ericdwatson/stm32-debug-board/hardware/manufacture/V1.0/assembly/stm32_debug_board_V1.0_JLCPCB_BOM.csv

Comment | Designator | Footprint | LCSC Part #
100nF | C1,C2,C3,C4,C5,C6,C7,C8,C9,C10,C11,C20,C21,C23,C25,C26,C29 | C_0805_2012Metric | C49678
30pF | C15,C16 | C_0603_1608Metric | C1658
2.2uF | C17,C18 | C_0805_2012Metric | C377773
4.7uF | C19 | C_0805_2012Metric | C1779
1uF | C22,C24 | C_0805_2012Metric | C28323
22uF | C27 | C_0805_2012Metric | C45783
22uF | C28 | CP_EIA-3528-21_Kemet-B | C7198
LED 0805 | D1,D2,D3 | LED_0805_2012Metric | C2296
500mA | F1 | Fuse_1206_3216Metric | C2984676
TYPE-C-31-M-12 | J1 | USB_C_Receptacle_HRO_TYPE-C-31-M-12 | C165948
FTSH-107-01-L-DV-K-A | J3 | SAMTEC_FTSH-107-01-L-DV-K-A | C5563894
100R | R1 | R_0805_2012Metric | C17408
1K | R2,R3,R4 | R_0805_2012Metric | C17513
10K | R5,R6,R7,R8 | R_0805_2012Metric | C17414
5.1K | R9,R10 | R_0805_2012Metric | C27834
Momentary switch | S1,S2 | SW_TS-1187A-B-A-B | C318884
STM32F446ZETx | U1 | LQFP-144_20x20mm_P0.5mm | C1337227
AMS1117-3.3 | U2 | SOT-223-3_TabPin2 | C6186
8 MHz | Y1 | Crystal_SMD_5032-2Pin_5.0x3.2mm | C115962
