ericdwatson/stm32-debug-board/hardware/docs/bom/stm32_debug_board.csv

Reference | Qty | Value | DNP | Exclude from BOM | Exclude from Board | Footprint | Datasheet | LCSC | MPN | Manufacturer | Farnell
C1,C2,C3,C4,C5,C6,C7,C8,C9,C10,C11,C20,C21,C23,C25,C26,C29 | 17 | 100nF |  |  |  | Capacitor_SMD:C_0805_2012Metric |  | C49678
C15,C16 | 2 | 30pF |  |  |  | Capacitor_SMD:C_0603_1608Metric |  | C1658 | 0603CG300J500NT | FH (Guangdong Fenghua Advanced Tech)
C17,C18 | 2 | 2.2uF |  |  |  | Capacitor_SMD:C_0805_2012Metric |  | C377773
C19 | 1 | 4.7uF |  |  |  | Capacitor_SMD:C_0805_2012Metric |  | C1779 | CL21A475KAQNNNE
C22,C24 | 2 | 1uF |  |  |  | Capacitor_SMD:C_0805_2012Metric |  | C28323
C27 | 1 | 22uF |  |  |  | Capacitor_SMD:C_0805_2012Metric |  | C45783 | CL21A226MAQNNNE
C28 | 1 | 22uF |  |  |  | Capacitor_Tantalum_SMD:CP_EIA-3528-21_Kemet-B |  | C7198 | TAJB226K010RNJ
D1 | 1 | PWR |  |  |  | LED_SMD:LED_0805_2012Metric |  | C2296 | KT-0805Y | Hubei KENTO Electronics
D2 | 1 | LED1 |  |  |  | LED_SMD:LED_0805_2012Metric |  | C2296 | KT-0805Y | Hubei KENTO Electronics
D3 | 1 | LED2 |  |  |  | LED_SMD:LED_0805_2012Metric |  | C2296 | KT-0805Y | Hubei KENTO Electronics
F1 | 1 | 500mA |  |  |  | Fuse:Fuse_1206_3216Metric |  | C2984676 | 500mA/24V | DOWO
J1 | 1 | TYPE-C-31-M-12 |  |  |  | Connector_USB:USB_C_Receptacle_HRO_TYPE-C-31-M-12 | https://www.usb.org/sites/default/files/documents/usb_type-c.zip | C165948 | TYPE-C-31-M-12 | Korean Hroparts Elec
J2 | 1 | Conn_02x10_Odd_Even |  |  |  | Connector_IDC:IDC-Header_2x10_P2.54mm_Vertical |  |  | TST-110-01-G-D | Samtec | 2667391
J3 | 1 | FTSH-107-01-L-DV-K-A |  |  |  | libraries:SAMTEC_FTSH-107-01-L-DV-K-A |  | C5563894 | FTSH-107-01-L-DV-K-A | Samtec
J4 | 1 | Conn_01x06 |  |  |  | Connector_PinHeader_2.54mm:PinHeader_1x06_P2.54mm_Vertical |  |  | TSW-106-07-G-S | Samtec | 2856716
J5 | 1 | Conn_01x02 |  |  |  | Connector_PinHeader_2.54mm:PinHeader_1x02_P2.54mm_Vertical |  |  |  | Samtec
R1 | 1 | 100R |  |  |  | Resistor_SMD:R_0805_2012Metric |  | C17408 | 0805W8F1000T5E | UNI-ROYAL
R2,R3,R4 | 3 | 1K |  |  |  | Resistor_SMD:R_0805_2012Metric |  | C17513 | 0805W8F1001T5E | UNI-ROYAL
R5,R6,R7,R8 | 4 | 10K |  |  |  | Resistor_SMD:R_0805_2012Metric |  | C17414 | 0805W8F1002T5E | UNI-ROYAL
R9,R10 | 2 | 5.1K |  |  |  | Resistor_SMD:R_0805_2012Metric |  | C27834 | 0805W8F5101T5E | UNI-ROYAL
S1 | 1 | User Button |  |  |  | libraries:SW_TS-1187A-B-A-B |  | C318884 | TS-1187A-B-A-B | XKB Industrial Precision
S2 | 1 | Reset Button |  |  |  | libraries:SW_TS-1187A-B-A-B |  | C318884 | TS-1187A-B-A-B | XKB Industrial Precision
U1 | 1 | STM32F446ZETx |  |  |  | Package_QFP:LQFP-144_20x20mm_P0.5mm | https://www.st.com/resource/en/datasheet/stm32f446ze.pdf | C1337227
U2 | 1 | AMS1117-3.3 |  |  |  | Package_TO_SOT_SMD:SOT-223-3_TabPin2 | http://www.advanced-monolithic.com/pdf/ds1117.pdf | C6186
Y1 | 1 | 8 MHz |  |  |  | Crystal:Crystal_SMD_5032-2Pin_5.0x3.2mm |  | C115962 | X50328MSB2GI | YXC
