ericdwatson/stm32-debug-board/hardware/docs/pdf/stm32_debug_board_v1_0.pdf

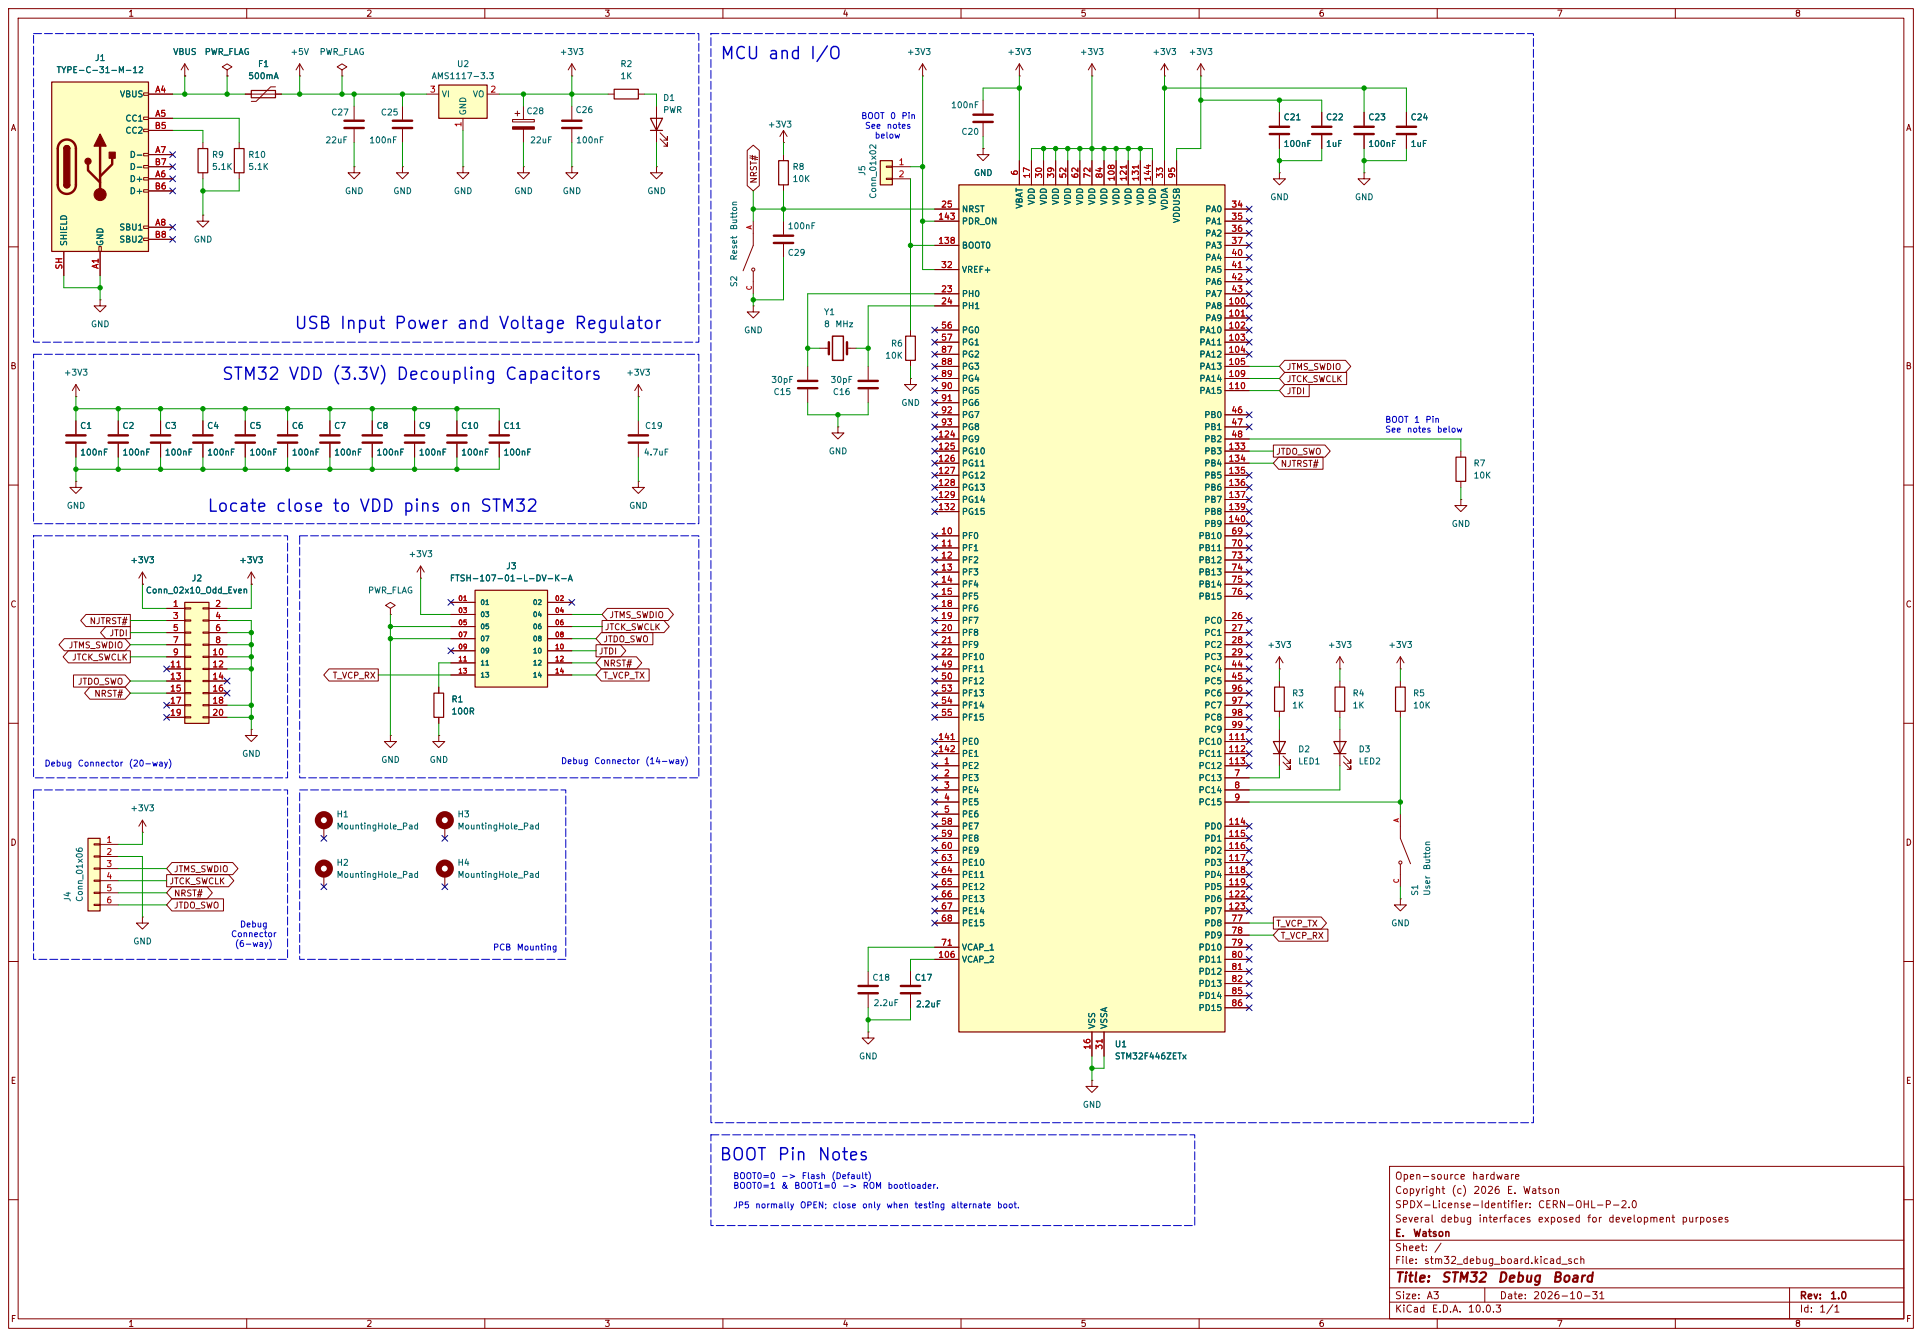
[picture p5: page 1]

BOOT 0 Pin See notes below

USB Input Power and Voltage Regulator

BOOT 1 Pin See notes below

Locate close to VDD pins on STM32

BOOT0=0 -> Flash (Default) BOOT0=1 & BOOT1=0 -> ROM bootloader. JP5 normally OPEN; close only when testing alternate boot. BOOT Pin Notes

Open-source hardware
Copyright (c) 2026 E. Watson
SPDX-License-Identifier: CERN-OHL-P-2.0
Several debug interfaces exposed for development purposes
E. Watson
Sheet: /
File: stm32_debug_board.kicad_sch
Title: STM32 Debug Board

Size: A3 | Rev: 1.0
KiCad E.D.A. 10.0.3 | Id: 1/1 | F Date: 2026-10-31
