ericdwatson/stm32-debug-board/hardware/stm32_debug_board.kicad_pcb

## KiCad design hardware/stm32_debug_board.kicad_pcb (2026-11-12)

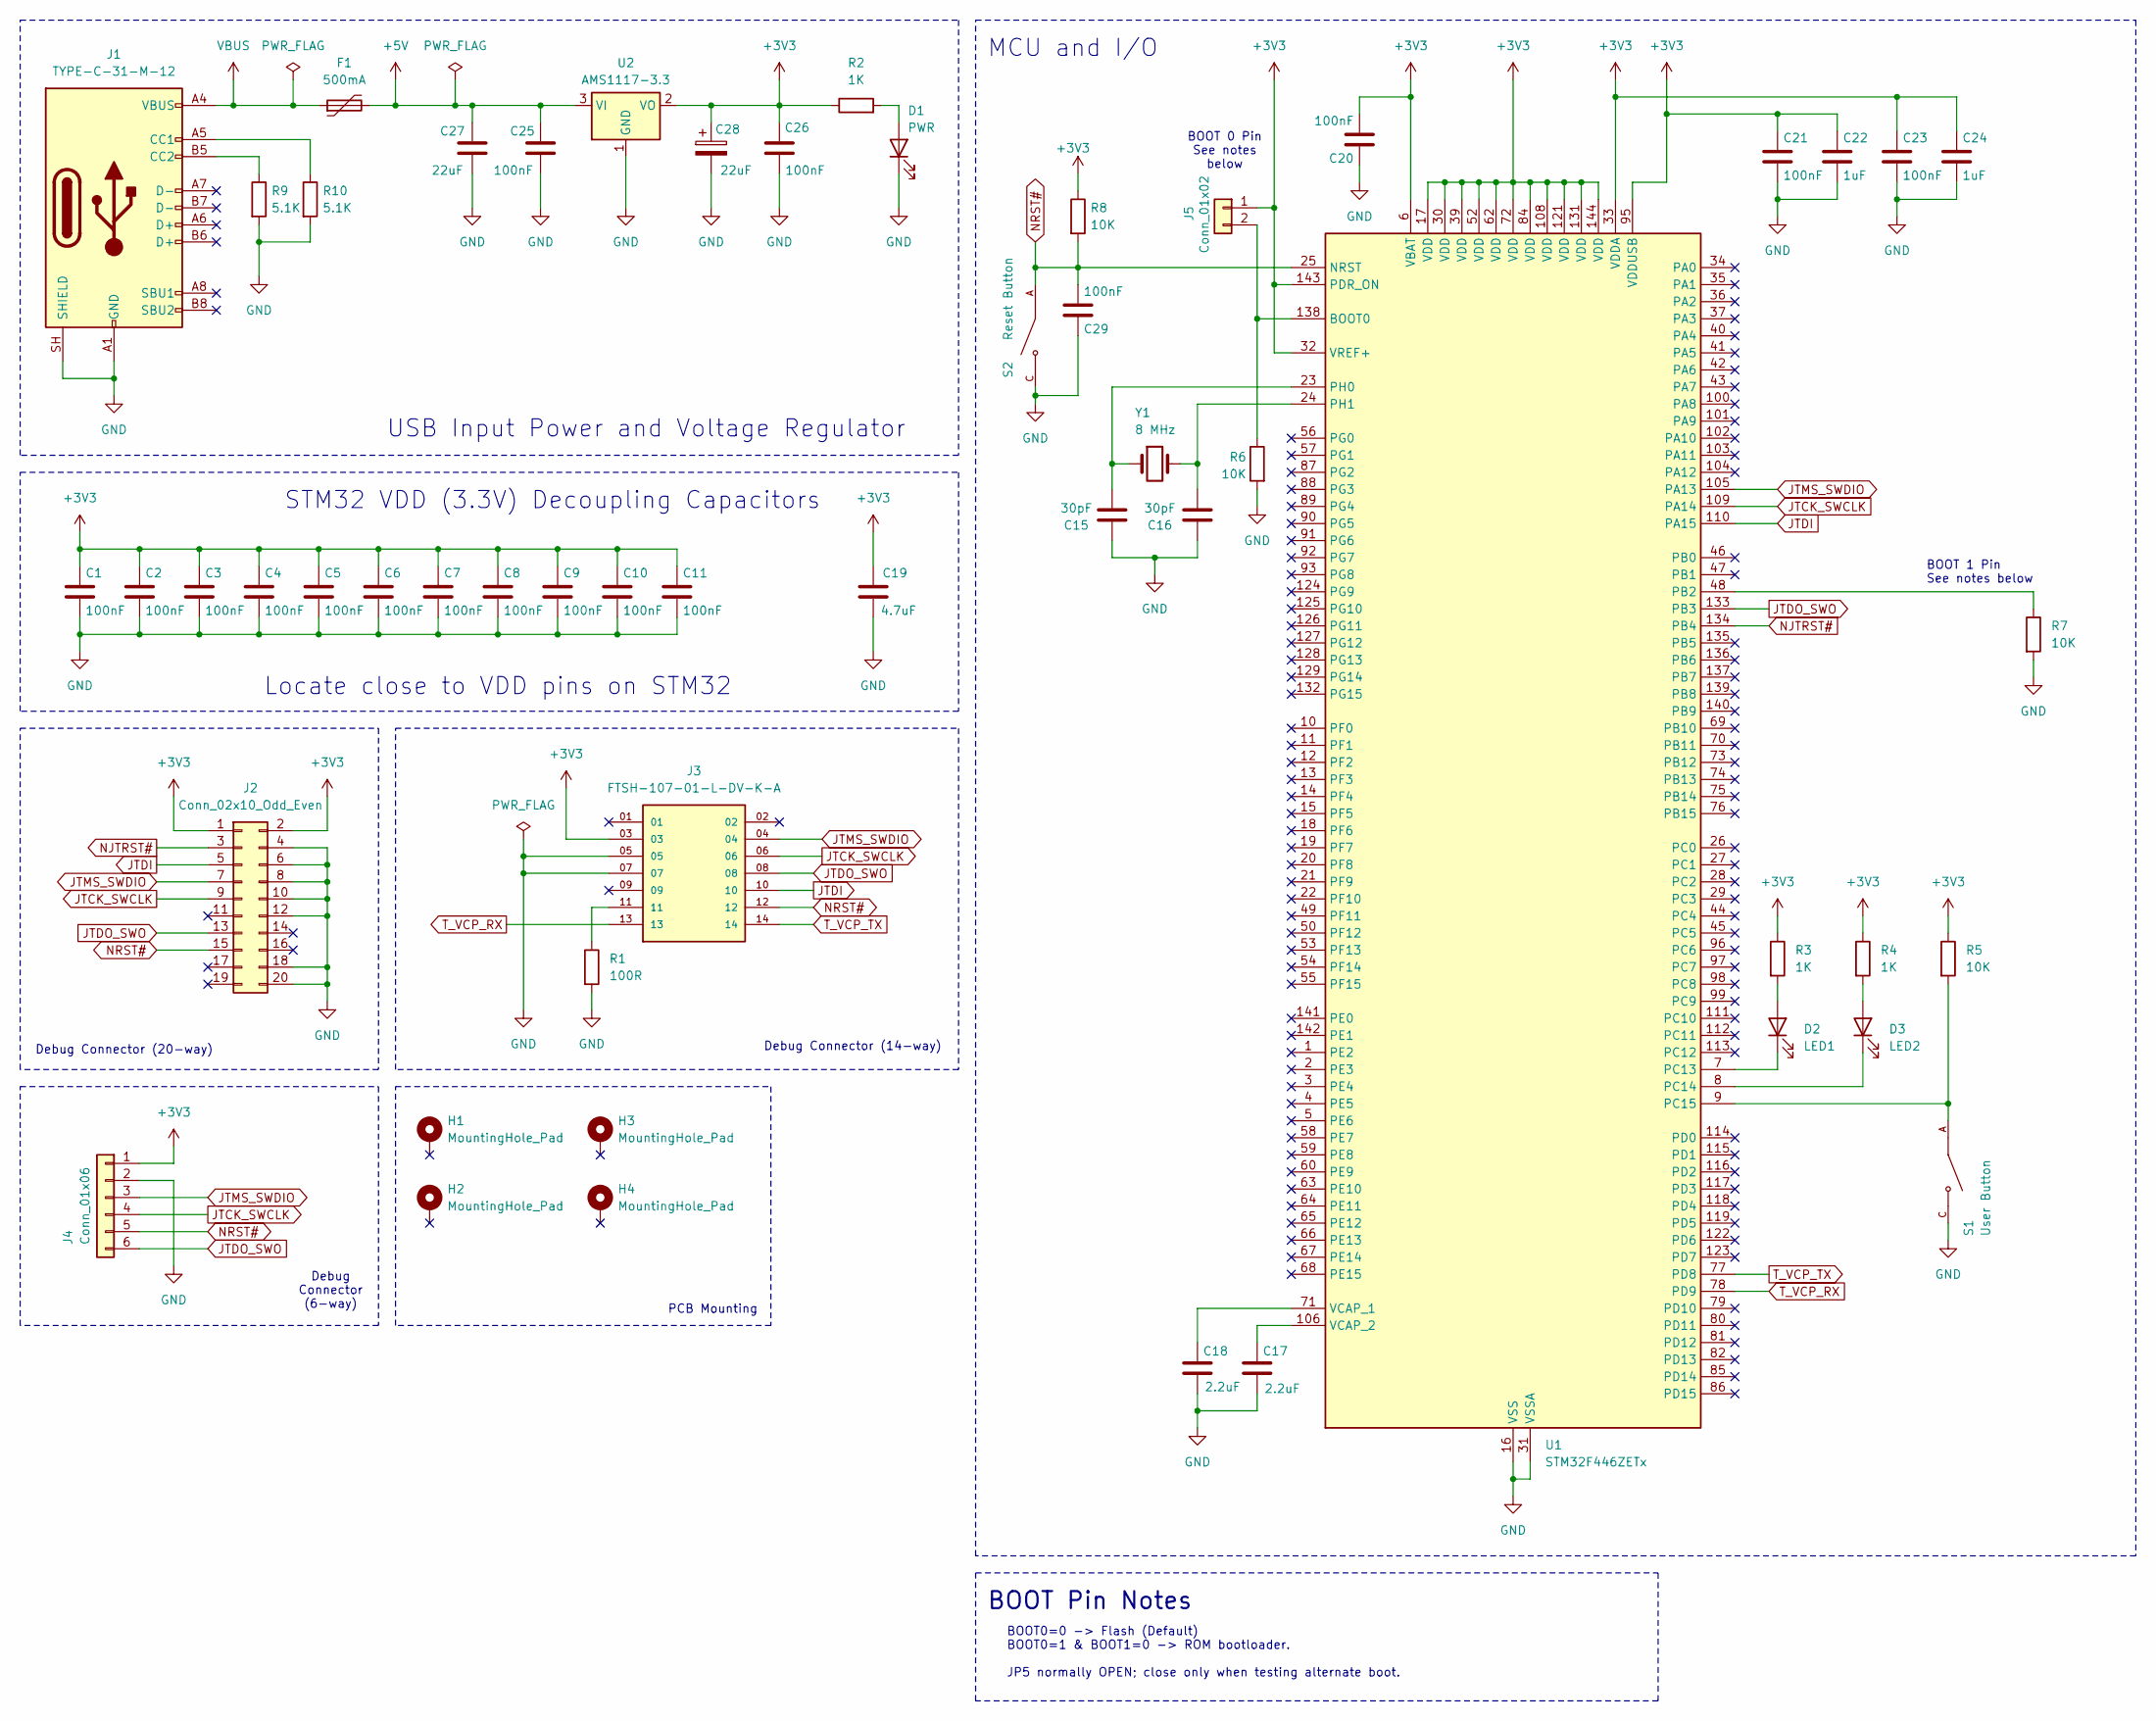
[picture p6: schematic stm32_debug_board.kicad_sch, STM32 Debug Board]

Parts:
C1, C2, C3, C4, C5, C6, C7, C8, C9, C10, C11, C20, C21, C23, C25, C26, C29: 100nF; C_0805_2012Metric; LCSC C49678
C15, C16: 30pF; C_0603_1608Metric; MPN 0603CG300J500NT; LCSC C1658
C17, C18: 2.2uF; C_0805_2012Metric; LCSC C377773
C19: 4.7uF; C_0805_2012Metric; MPN CL21A475KAQNNNE; LCSC C1779
C22, C24: 1uF; C_0805_2012Metric; LCSC C28323
C27: 22uF; C_0805_2012Metric; MPN CL21A226MAQNNNE; LCSC C45783
C28: 22uF; CP_EIA-3528-21_Kemet-B; MPN TAJB226K010RNJ; LCSC C7198
D1: PWR; LED_0805_2012Metric; MPN KT-0805Y; LCSC C2296
D2: LED1; LED_0805_2012Metric; MPN KT-0805Y; LCSC C2296
D3: LED2; LED_0805_2012Metric; MPN KT-0805Y; LCSC C2296
F1: 500mA; Fuse_1206_3216Metric; MPN 500mA/24V; LCSC C2984676
H1, H2, H3, H4: MountingHole_Pad; MountingHole_3.2mm_M3_Pad
J1: TYPE-C-31-M-12; USB_C_Receptacle_HRO_TYPE-C-31-M-12; MPN TYPE-C-31-M-12; LCSC C165948
J2: Conn_02x10_Odd_Even; IDC-Header_2x10_P2.54mm_Vertical; MPN TST-110-01-G-D; Farnell 2667391
J3: FTSH-107-01-L-DV-K-A; SAMTEC_FTSH-107-01-L-DV-K-A; PARTREV H; LCSC C5563894
J4: Conn_01x06; PinHeader_1x06_P2.54mm_Vertical; MPN TSW-106-07-G-S; Farnell 2856716
J5: Conn_01x02; PinHeader_1x02_P2.54mm_Vertical
R1: 100R; R_0805_2012Metric; MPN 0805W8F1000T5E; LCSC C17408
R2, R3, R4: 1K; R_0805_2012Metric; MPN 0805W8F1001T5E; LCSC C17513
R5, R6, R7, R8: 10K; R_0805_2012Metric; MPN 0805W8F1002T5E; LCSC C17414
R9, R10: 5.1K; R_0805_2012Metric; MPN 0805W8F5101T5E; LCSC C27834
S1: User Button; SW_TS-1187A-B-A-B; PARTREV A0; LCSC C318884
S2: Reset Button; SW_TS-1187A-B-A-B; PARTREV A0; LCSC C318884
U1: STM32F446ZETx; LQFP-144_20x20mm_P0.5mm; LCSC C1337227
U2: AMS1117-3.3; SOT-223-3_TabPin2; LCSC C6186
Y1: 8 MHz; Crystal_SMD_5032-2Pin_5.0x3.2mm; MPN X50328MSB2GI; LCSC C115962

Connections:
+3V3: C1.1, C2.1, C3.1, C4.1, C5.1, C6.1, C7.1, C8.1, C9.1, C10.1, C11.1, C19.1, C20.2, C21.1, C22.1, C23.1, C24.1, C26.2, C28.1, J2.1, J2.2, J3.03, J4.1, J5.1, R2.1, R3.1, R4.1, R5.1, R8.1, U1.6 (VBAT), U1.17 (VDD), U1.30 (VDD), U1.32 (VREF+), U1.33 (VDDA), U1.39 (VDD), U1.52 (VDD), U1.62 (VDD), U1.72 (VDD), U1.84 (VDD), U1.95 (VDDUSB), U1.108 (VDD), U1.121 (VDD), U1.131 (VDD), U1.143 (PDR_ON), U1.144 (VDD), U2.2 (VO)
+5V: C25.2, C27.2, F1.2, U2.3 (VI)
GND: C1.2, C2.2, C3.2, C4.2, C5.2, C6.2, C7.2, C8.2, C9.2, C10.2, C11.2, C15.1, C16.1, C17.2, C18.2, C19.2, C20.1, C21.2, C22.2, C23.2, C24.2, C25.1, C26.1, C27.1, C28.2, C29.1, D1.1 (K), J1.A1 (GND), J1.A12 (GND), J1.B1 (GND), J1.B12 (GND), J1.SH (SHIELD), J2.4, J2.6, J2.8, J2.10, J2.12, J2.18, J2.20, J3.05, J3.07, J4.2, R1.2, R6.2, R7.2, R9.2, R10.2, S1.C, S1.D, S2.C, S2.D, U1.16 (VSS), U1.31 (VSSA), U1.38 (VSS), U1.51 (VSS), U1.61 (VSS), U1.83 (VSS), U1.94 (VSS), U1.107 (VSS), U1.120 (VSS), U1.130 (VSS), U2.1 (GND)
JTCK_SWCLK: J2.9, J3.06, J4.4, U1.109 (PA14)
JTDI: J2.5, J3.10, U1.110 (PA15)
JTDO_SWO: J2.13, J3.08, J4.6, U1.133 (PB3)
JTMS_SWDIO: J2.7, J3.04, J4.3, U1.105 (PA13)
NJTRST#: J2.3, U1.134 (PB4)
NRST#: C29.2, J2.15, J3.12, J4.5, R8.2, S2.A, S2.B, U1.25 (NRST)
unnamed: D1.2 (A), R2.2
unnamed: D2.2 (A), R3.2
unnamed: D2.1 (K), U1.7 (PC13)
unnamed: D3.2 (A), R4.2
unnamed: D3.1 (K), U1.8 (PC14)
unnamed: J1.A5 (CC1), R10.1
unnamed: J1.B5 (CC2), R9.1
unnamed: J3.11, R1.1
unnamed: J5.2, R6.1, U1.138 (BOOT0)
unnamed: R7.1, U1.48 (PB2)
unnamed: R5.2, S1.A, S1.B, U1.9 (PC15)
unnamed: C15.2, U1.23 (PH0), Y1.1
unnamed: C16.2, U1.24 (PH1), Y1.2
unnamed: C18.1, U1.71 (VCAP_1)
unnamed: C17.1, U1.106 (VCAP_2)
T_VCP_RX: J3.13, U1.78 (PD9)
T_VCP_TX: J3.14, U1.77 (PD8)
VBUS: F1.1, J1.A4 (VBUS), J1.A9 (VBUS), J1.B4 (VBUS), J1.B9 (VBUS)

Notes on the sheet:
MCU and I/O
Debug Connector (20-way)
BOOT0=0 -> Flash (Default) BOOT0=1 & BOOT1=0 -> ROM bootloader. JP5 normally OPEN; close only when testing alternate boot.
Locate close to VDD pins on STM32
PCB Mounting
Debug Connector (6-way)
USB Input Power and Voltage Regulator
BOOT 1 Pin See notes below
BOOT 0 Pin See notes below
Debug Connector (14-way)
STM32 VDD (3.3V) Decoupling Capacitors
BOOT Pin Notes

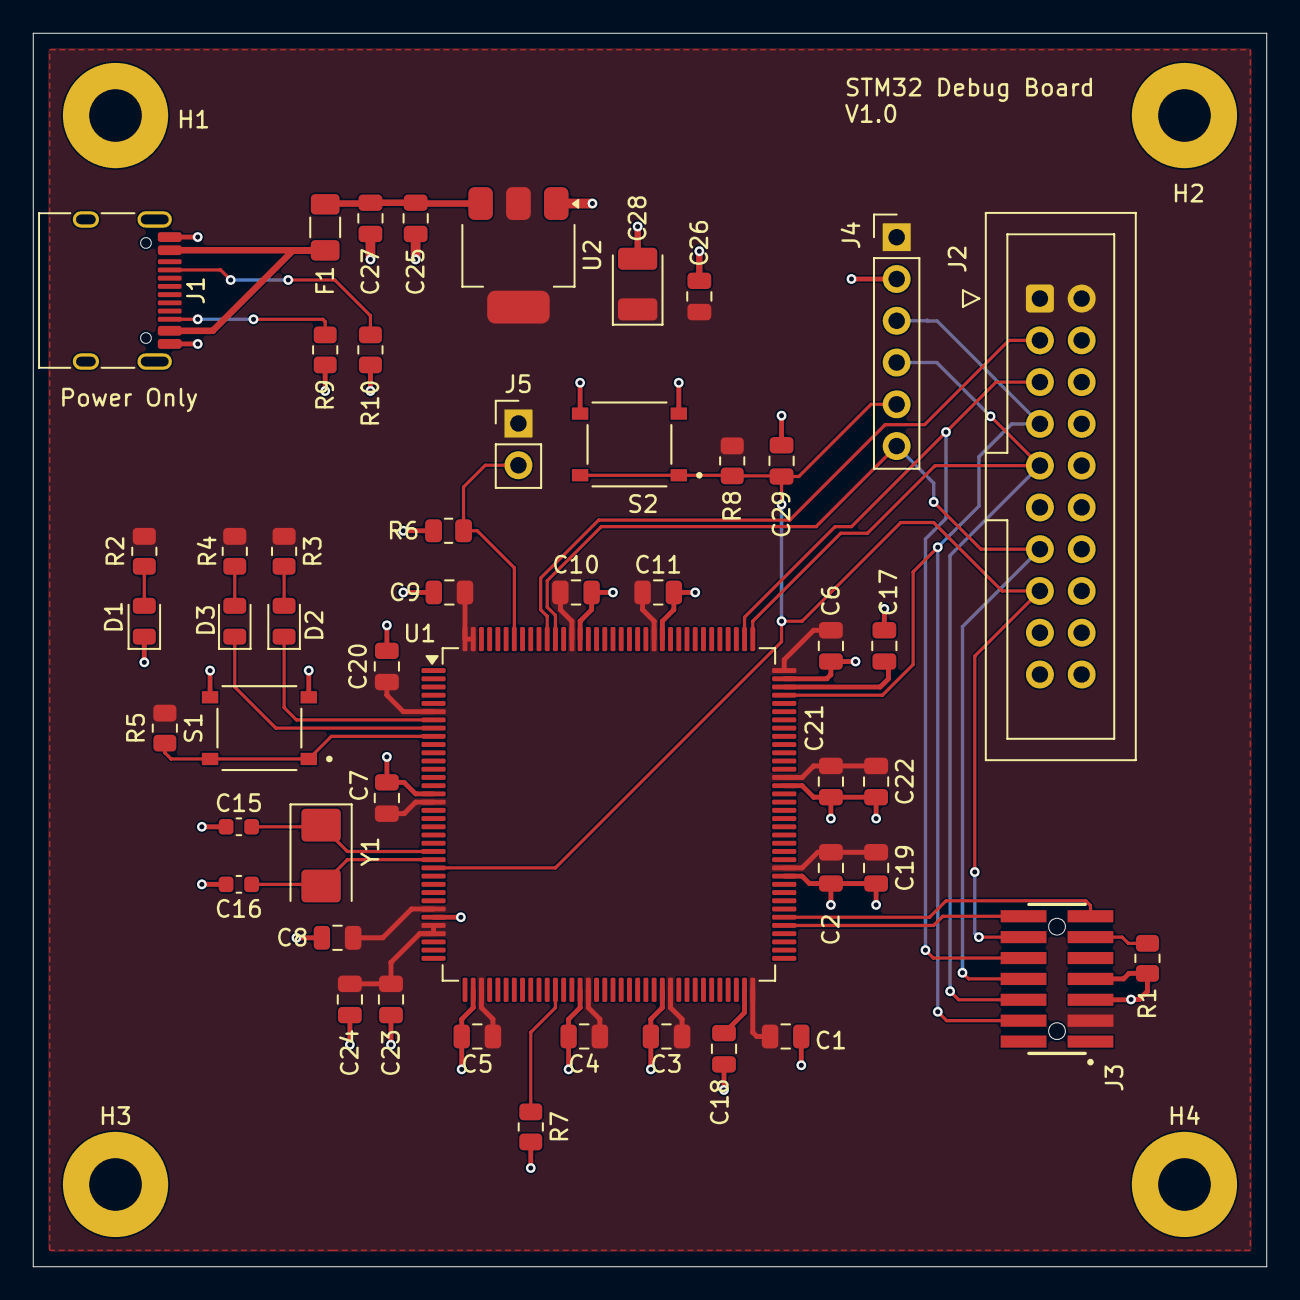
[picture p7: board stm32_debug_board.kicad_pcb from above]

Board: 2 copper layers, 75.0 x 75.0 mm, 54 parts (0 on the bottom side), 27 nets.
