ericdwatson/stm32-debug-board/software/stm32_debug_board_test/Src/main.c

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
/* Includes ------------------------------------------------------------------*/
#include "main.h"
#include "usart.h"
#include "gpio.h"


void SystemClock_Config(void);
/**
  * @brief  The application entry point.
  * @retval int
  */
int main(void)
{

  /* MCU Configuration--------------------------------------------------------*/

  /* Reset of all peripherals, Initializes the Flash interface and the Systick. */
  HAL_Init();

  /* Configure the system clock */
  SystemClock_Config();

  /* Initialize all configured peripherals */
  MX_GPIO_Init();
  MX_USART3_UART_Init();
  /* USER CODE BEGIN 2 */

  uint8_t startupMessage[] = "STM32 Debug Board V1.0\r\n"
                             "Firmware started\r\n";

  uint8_t heartbeatMessage[] = "Running...\r\n";

  const char swoMessage[] = "SWO: Running...\r\n";

  HAL_UART_Transmit(&huart3,
                    startupMessage,
                    sizeof(startupMessage) - 1,
                    100);

  uint32_t lastLedTick = HAL_GetTick();
  uint32_t lastHeartbeatTick = HAL_GetTick();

  uint8_t ledState = 0;
  uint8_t rxByte;

  /* User button variables */
  GPIO_PinState lastButtonState =
      HAL_GPIO_ReadPin(USER_BUTTON_GPIO_Port, USER_BUTTON_Pin);

  GPIO_PinState stableButtonState = lastButtonState;

  uint32_t lastButtonTick = HAL_GetTick();

  uint8_t buttonPressedMessage[] = "Button pressed\r\n";
  uint8_t buttonReleasedMessage[] = "Button released\r\n";


  /* USER CODE END 2 */

  /* Infinite loop */
  /* USER CODE BEGIN WHILE */
  while (1)
  {
    /* USER CODE END WHILE */

    /* USER CODE BEGIN 3 */

    uint32_t currentTick = HAL_GetTick();

    /* Alternate LEDs every 500 ms */
    if ((currentTick - lastLedTick) >= 500U)
    {
      lastLedTick = currentTick;

      if (ledState == 0)
      {
        HAL_GPIO_WritePin(LED2_GPIO_Port, LED2_Pin, GPIO_PIN_SET);
        HAL_GPIO_WritePin(LED1_GPIO_Port, LED1_Pin, GPIO_PIN_RESET);

        ledState = 1;
      }
      else
      {
        HAL_GPIO_WritePin(LED1_GPIO_Port, LED1_Pin, GPIO_PIN_SET);
        HAL_GPIO_WritePin(LED2_GPIO_Port, LED2_Pin, GPIO_PIN_RESET);

        ledState = 0;
      }
    }

    /* Transmit heartbeat every second */
    if ((currentTick - lastHeartbeatTick) >= 1000U)
    {
      lastHeartbeatTick = currentTick;

      HAL_UART_Transmit(&huart3,
                        heartbeatMessage,
                        sizeof(heartbeatMessage) - 1,
                        100);

      /* SWO heartbeat */
      for (uint32_t i = 0; i < sizeof(swoMessage) - 1; i++)
      {
        ITM_SendChar(swoMessage[i]);
      }
    }

    /* Receive and echo a character */
    if (HAL_UART_Receive(&huart3, &rxByte, 1, 0) == HAL_OK)
    {
      HAL_UART_Transmit(&huart3, &rxByte, 1, 100);
    }


    /* Read user button */
    GPIO_PinState buttonState =
        HAL_GPIO_ReadPin(USER_BUTTON_GPIO_Port, USER_BUTTON_Pin);

    /* Restart debounce timer whenever the input changes */
    if (buttonState != lastButtonState)
    {
      lastButtonState = buttonState;
      lastButtonTick = currentTick;
    }

    /* Accept the new state after 20 ms of stability */
    if ((currentTick - lastButtonTick) >= 20U)
    {
      if (buttonState != stableButtonState)
      {
        stableButtonState = buttonState;

        if (stableButtonState == GPIO_PIN_RESET)
        {
          HAL_UART_Transmit(&huart3,
                            buttonPressedMessage,
                            sizeof(buttonPressedMessage) - 1,
                            100);
        }
        else
        {
          HAL_UART_Transmit(&huart3,
                            buttonReleasedMessage,
                            sizeof(buttonReleasedMessage) - 1,
                            100);
        }
      }
    }
  }
  /* USER CODE END 3 */
}

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
