ericdwatson/stm32-debug-board/software/stm32_debug_board_test/stm32_debug_board_test.ioc

Mcu.UserName=STM32F446ZETx
PA13.Signal=SYS_JTMS-SWDIO
PA14.Signal=SYS_JTCK-SWCLK
PB3.Signal=SYS_JTDO-SWO
PC13.GPIO_Label=LED1
PC13.Signal=GPIO_Output
PC14-OSC32_IN.GPIO_Label=LED2
PC14-OSC32_IN.Signal=GPIO_Output
PC15-OSC32_OUT.GPIO_Label=USER_BUTTON
PC15-OSC32_OUT.Signal=GPIO_Input
PD8.GPIO_Label=T_VCP_TX
PD8.Signal=USART3_TX
PD9.GPIO_Label=T_VCP_RX
PD9.Signal=USART3_RX
PH0-OSC_IN.Signal=RCC_OSC_IN
PH1-OSC_OUT.Signal=RCC_OSC_OUT
