ericdwatson/stm32-debug-board/software/stm32_debug_board_test/Inc/main.h

#define LED1_Pin GPIO_PIN_13
#define LED1_GPIO_Port GPIOC
#define LED2_Pin GPIO_PIN_14
#define LED2_GPIO_Port GPIOC
#define USER_BUTTON_Pin GPIO_PIN_15
#define USER_BUTTON_GPIO_Port GPIOC
#define T_VCP_TX_Pin GPIO_PIN_8
#define T_VCP_TX_GPIO_Port GPIOD
#define T_VCP_RX_Pin GPIO_PIN_9
#define T_VCP_RX_GPIO_Port GPIOD
