ericdwatson/stm32-debug-board/(commit log)

2026-11-12 Initial commit - STM32 Debug Board hardware V1.0
    [stm32_debug_board-B_Cu.gbl, stm32_debug_board-B_Mask.gbs, stm32_debug_board-Edge_Cuts.gm1, stm32_debug_board-F_Cu.gtl, stm32_debug_board-F_Mask.gts, stm32_debug_board-F_Paste.gtp, stm32_debug_board-F_Silkscreen.gto, stm32_debug_board-NPTH-drl_map.gbr]
2026-11-12 Add initial STM32CubeMX-generated firmware project
2026-11-12 Add LED test application and SWD debug configuration
2026-11-12 Add UART heartbeat and character echo via STDC14 virtual COM port
2026-11-12 Add debounced user button handling and verify hardware reset
    [main.c]
2026-11-12 Add JTAG debug configuration and validate 20-pin interface
2026-11-12 Add hardware validation report, board photographs and project documentation
2026-11-12 Add open-source project licences and third-party attribution
    [stm32_debug_board.kicad_pcb, stm32_debug_board.kicad_sch]
