ericdwatson/stm32-debug-board/(notices)

Notices in the files:
software/stm32_debug_board_test/Inc/main.h:
Copyright (c) 2026 STMicroelectronics.
All rights reserved.
This software is licensed under terms that can be found in the LICENSE file
software/stm32_debug_board_test/Src/main.c:
Licensed under the MIT License.
